TaiwebRahman47/Convenient-Bamboo-Cutter/Render Images/Pulley Holder.JPG

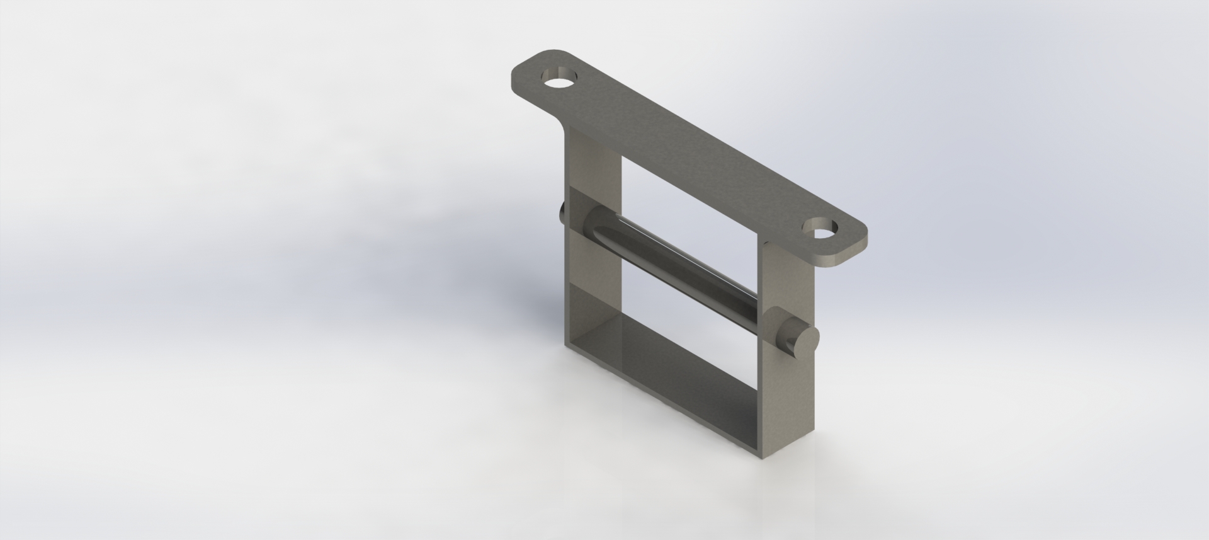
Render Images/Pulley Holder.JPG
