TaiwebRahman47/Convenient-Bamboo-Cutter/Render Images/Rammer.JPG

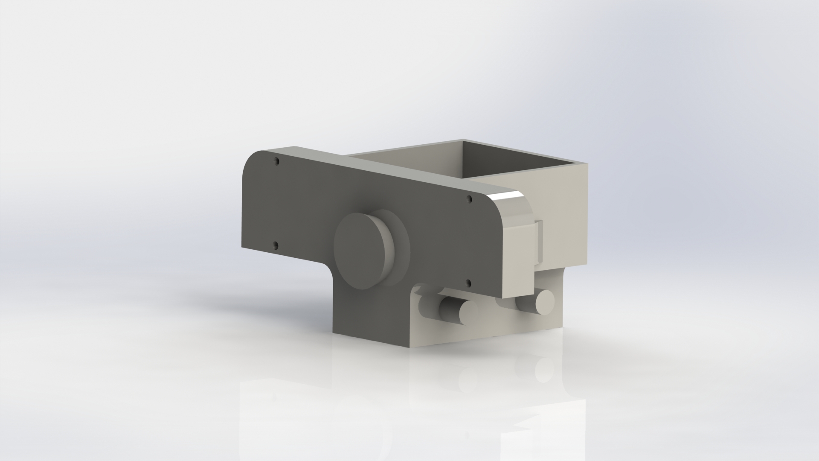
Render Images/Rammer.JPG
