TaiwebRahman47/Convenient-Bamboo-Cutter/Render Images/Bamboo Cutter.JPG

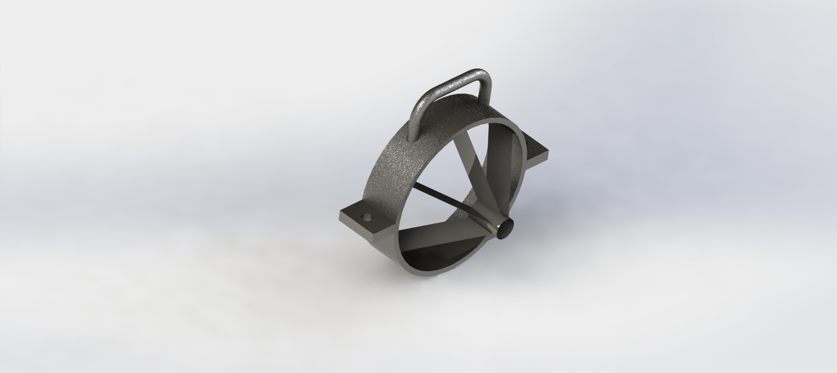
Render Images/Bamboo Cutter.JPG
