TaiwebRahman47/Convenient-Bamboo-Cutter/Render Images/Bamboo Cutting Machine.JPG

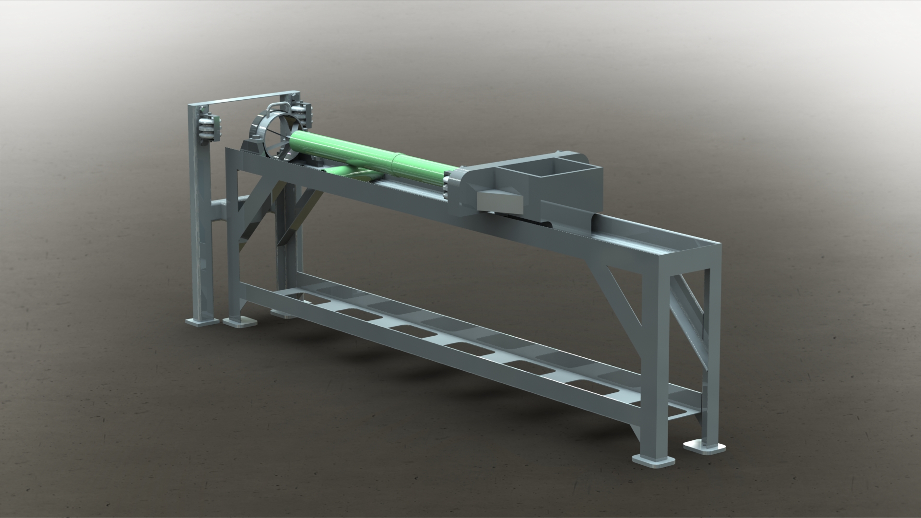
Render Images/Bamboo Cutting Machine.JPG
