TaiwebRahman47/Convenient-Bamboo-Cutter/Render Images/Bamboo Sample.JPG

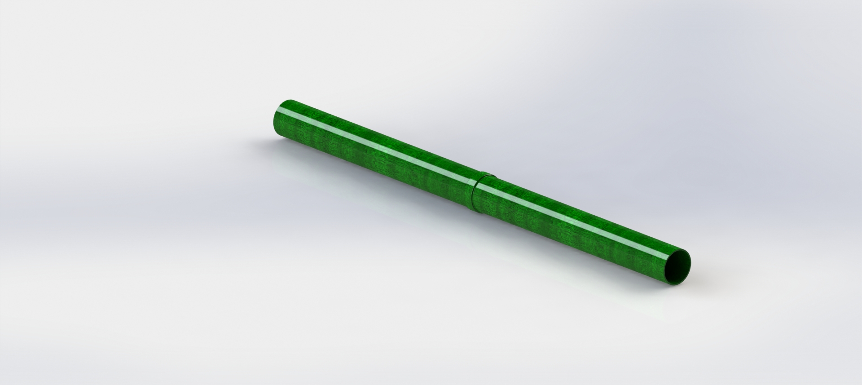
Render Images/Bamboo Sample.JPG
