TaiwebRahman47/Convenient-Bamboo-Cutter/Render Images/Bearings.JPG

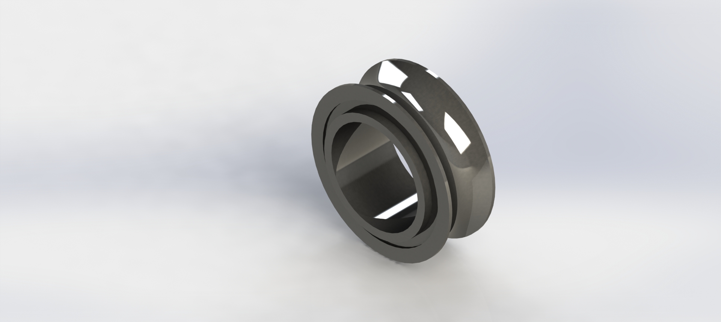
Render Images/Bearings.JPG
