TaiwebRahman47/Convenient-Bamboo-Cutter/Render Images/Cutter Holder.JPG

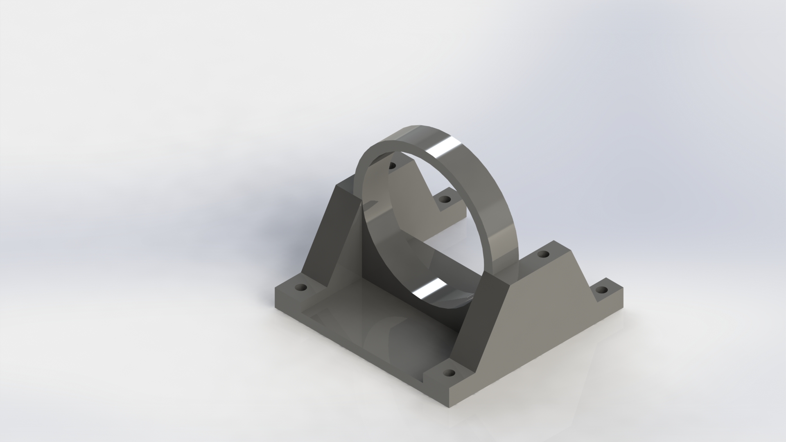
Render Images/Cutter Holder.JPG
