TaiwebRahman47/Convenient-Bamboo-Cutter/Render Images/Nut.JPG

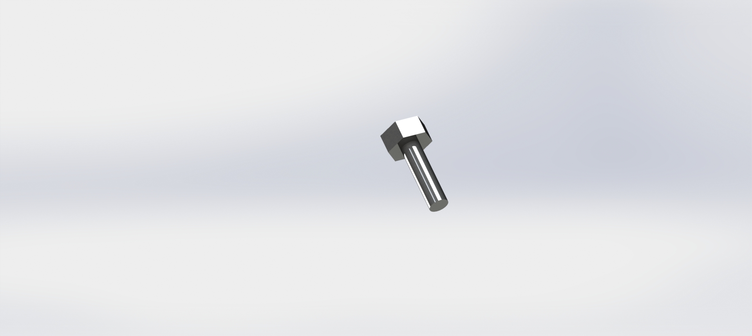
Render Images/Nut.JPG
