TaiwebRahman47/Convenient-Bamboo-Cutter/Solidworks Files/Main Frame.SLDPRT

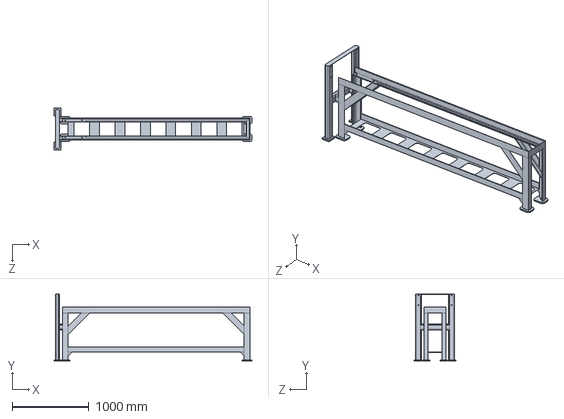
[picture p109: CAD file, 2026-10-26]
Solidworks Files/Main Frame.SLDPRT
2571.8 x 866.1 x 546.1 mm
