TaiwebRahman47/Convenient-Bamboo-Cutter/Solidworks Files/Bamboo Cutting Machine.SLDASM

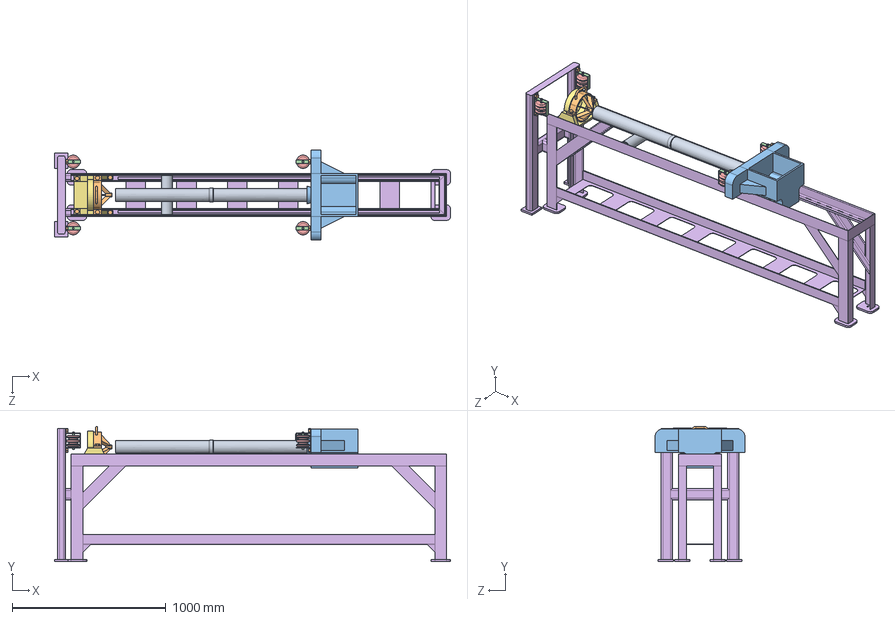
[picture p110: CAD file, 2026-10-26]
Solidworks Files/Bamboo Cutting Machine.SLDASM
2571.8 x 878.8 x 584.2 mm
Bamboo Cutter
Bamboo Sample
Bearings x 4
Cutter Holder
Main Frame
Pulley x 4
Pulley Holder x 4
Rammer
Nut x 14
Bamboo Support
