TaiwebRahman47/Convenient-Bamboo-Cutter/Solidworks Files/Pulley Holder.SLDPRT

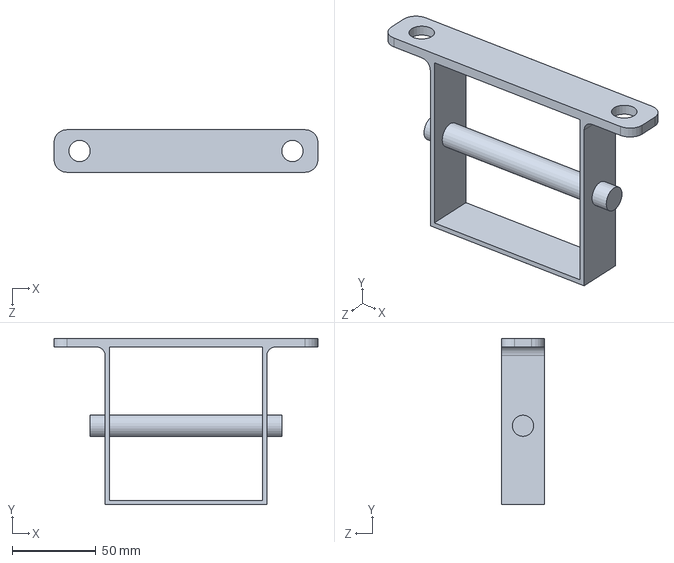
[picture p111: CAD file, 2026-10-26]
Solidworks Files/Pulley Holder.SLDPRT
157.5 x 99.1 x 25.4 mm
