TaiwebRahman47/Convenient-Bamboo-Cutter/Solidworks Files/Rammer.SLDPRT

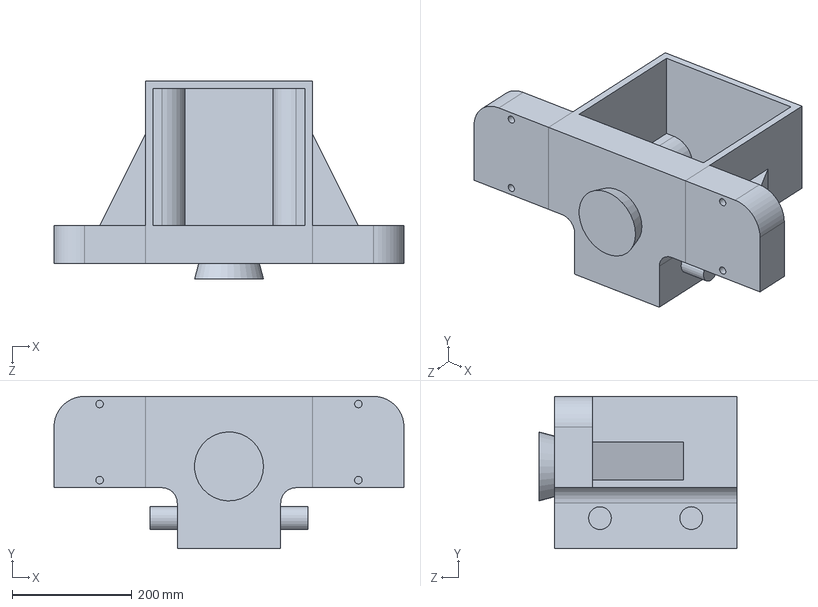
[picture p112: CAD file, 2026-10-26]
Solidworks Files/Rammer.SLDPRT
584.2 x 254.0 x 330.2 mm
