TaiwebRahman47/Convenient-Bamboo-Cutter/Solidworks Files/Pulley.SLDPRT

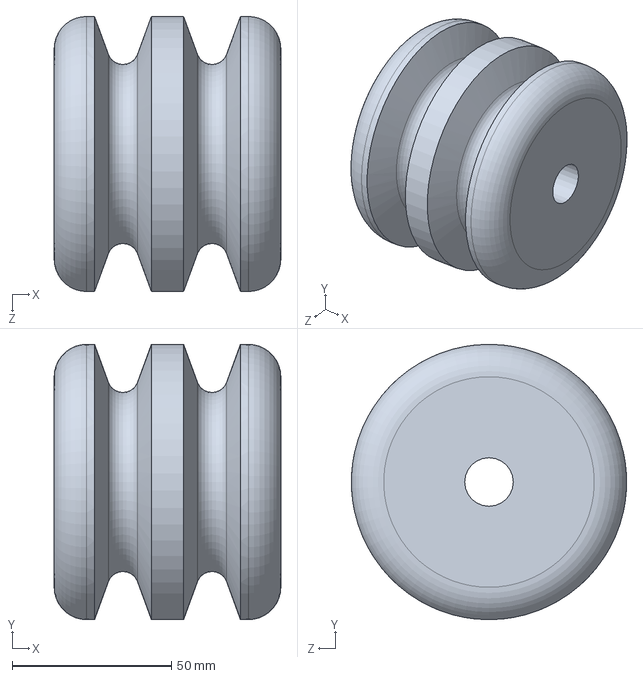
[picture p113: CAD file, 2026-10-26]
Solidworks Files/Pulley.SLDPRT
71.1 x 86.4 x 86.3 mm
