TaiwebRahman47/Convenient-Bamboo-Cutter/Solidworks Files/Bamboo Sample.SLDPRT

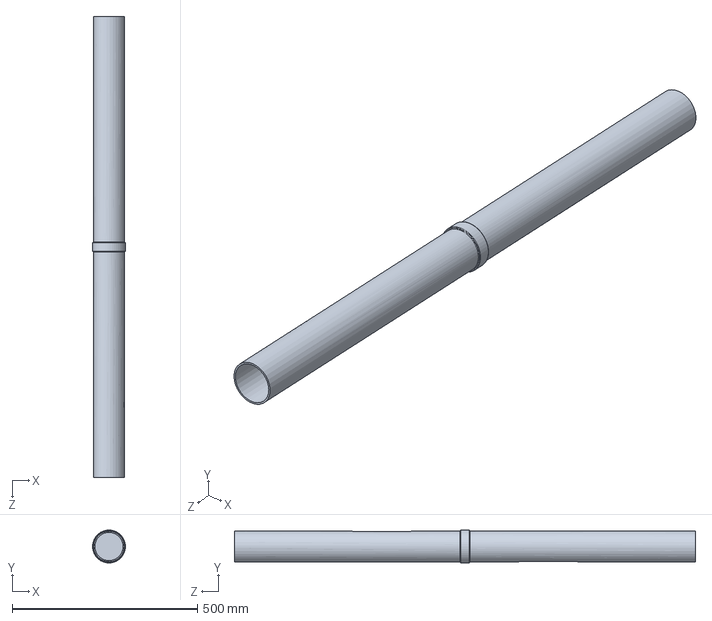
[picture p114: CAD file, 2026-10-26]
Solidworks Files/Bamboo Sample.SLDPRT
88.8 x 88.8 x 1244.6 mm
