TaiwebRahman47/Convenient-Bamboo-Cutter/Solidworks Files/Bamboo Support.SLDPRT

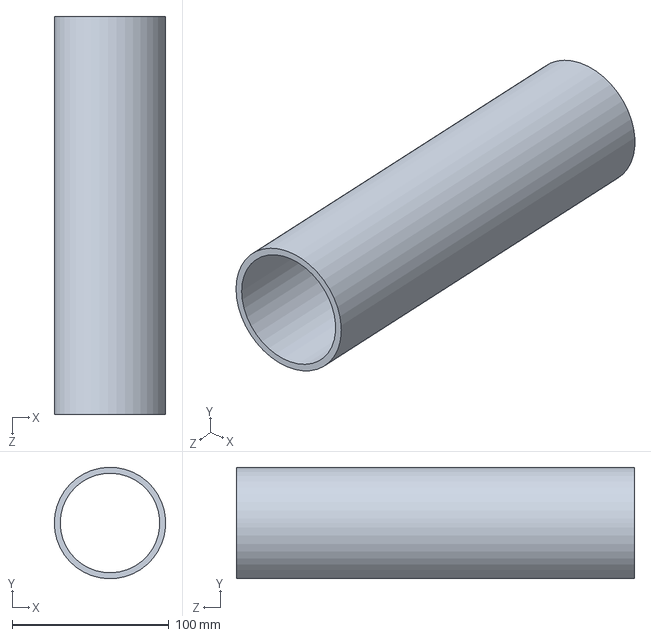
[picture p115: CAD file, 2026-10-26]
Solidworks Files/Bamboo Support.SLDPRT
71.1 x 71.1 x 254.0 mm
