TaiwebRahman47/Convenient-Bamboo-Cutter/Solidworks Files/Bearings.SLDPRT

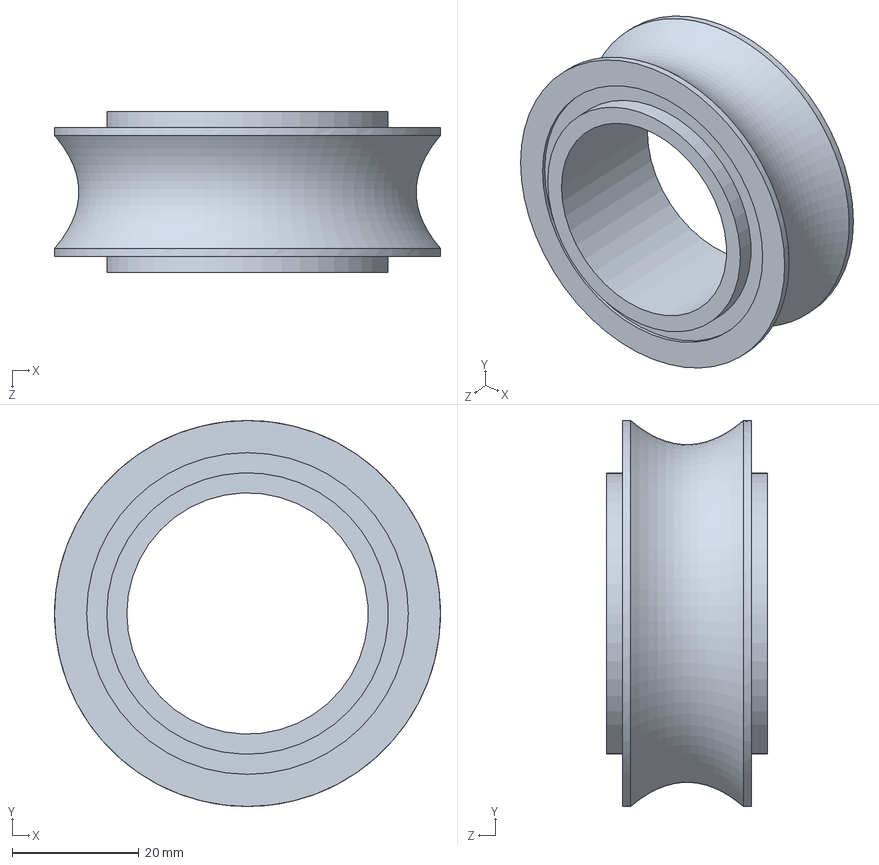
[picture p116: CAD file, 2026-10-26]
Solidworks Files/Bearings.SLDPRT
61.0 x 61.0 x 25.4 mm
