TaiwebRahman47/Convenient-Bamboo-Cutter/Solidworks Files/Bamboo Cutter.SLDPRT

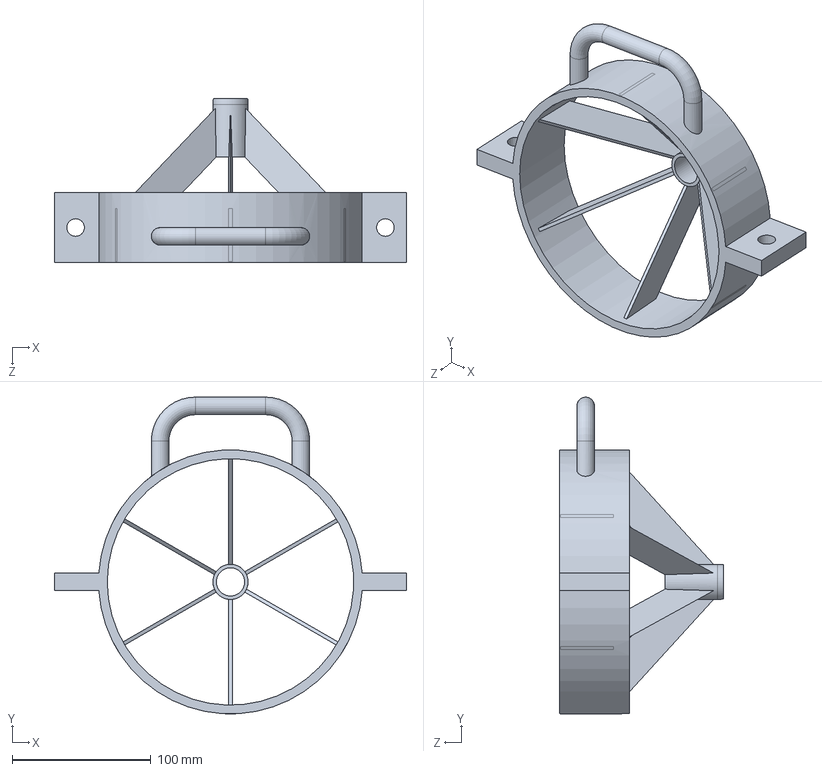
[picture p117: CAD file, 2026-10-26]
Solidworks Files/Bamboo Cutter.SLDPRT
254.0 x 228.6 x 118.7 mm
