TaiwebRahman47/Convenient-Bamboo-Cutter/Solidworks Files/Cutter Holder.SLDPRT

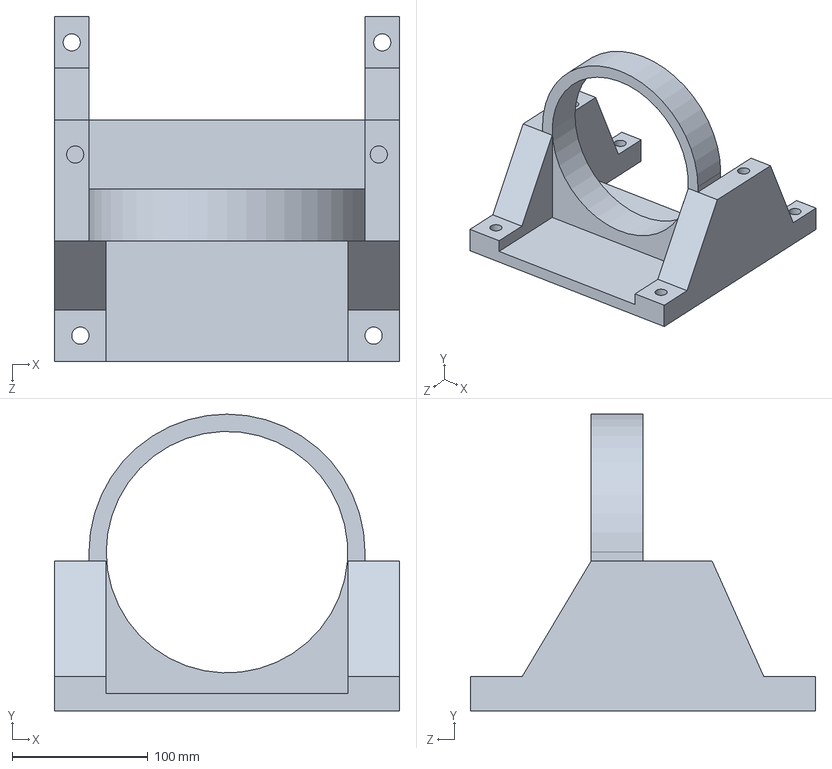
[picture p118: CAD file, 2026-10-26]
Solidworks Files/Cutter Holder.SLDPRT
254.0 x 218.4 x 254.0 mm
