TaiwebRahman47/Convenient-Bamboo-Cutter/Solidworks Files/Nut.SLDPRT

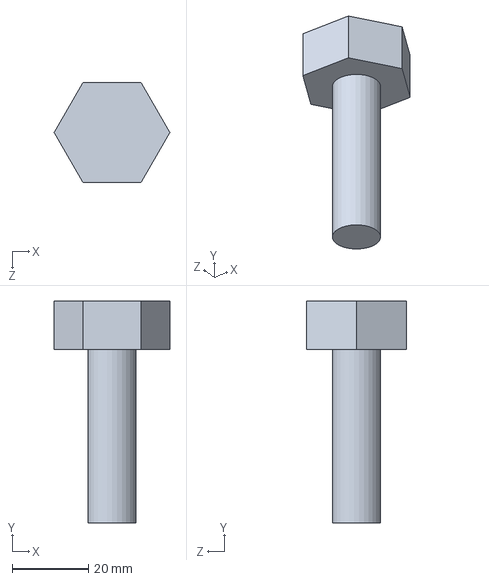
[picture p119: CAD file, 2026-10-26]
Solidworks Files/Nut.SLDPRT
30.5 x 58.4 x 26.4 mm
